SudhanshuAgrawal27/arduino_target_finder_rl/assets/schematic_circuit_diagram.pdf

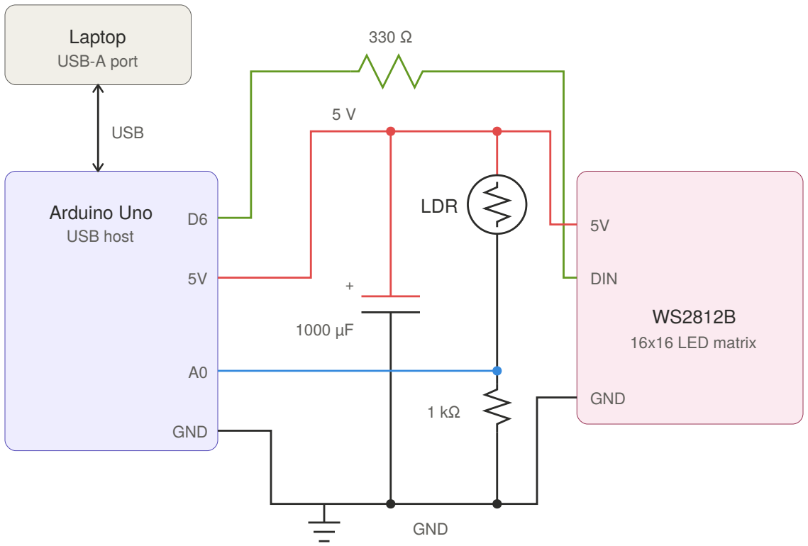
[picture p7: figure]
Laptop USB-A port; Arduino Uno USB host; GND; WS2812B 16x16 LED matrix; DIN; USB; LDR
