SudhanshuAgrawal27/arduino_target_finder_rl/assets/led-grid-picture.png

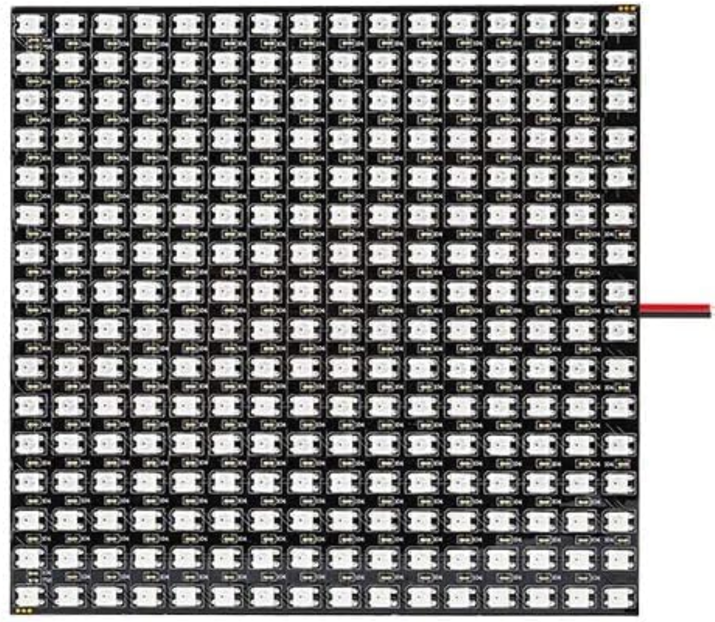
assets/led-grid-picture.png
