SudhanshuAgrawal27/arduino_target_finder_rl/conf/config.yaml

# Fast smoke-test config for train.py. Override any field from the command line,
# e.g.: python3 train.py training.num_epochs=5 ppo.learning_rate=1e-4

defaults:
  - override hydra/job_logging: disabled  # we do our own logging via accelerator.print
  - override hydra/hydra_logging: disabled
  - _self_

hydra:
  run:
    dir: .              # we manage our own run directory (trained_models/<run_name>/)
  output_subdir: null

seeds: [42]  # train one model per seed; override e.g. seeds=[42,43,44]

env:
  grid_size: 16
  subgrid_size: 8
  score_radius: 2
  max_steps: 100
  history_length: 4
  step_penalty: 0.01     # reward cost per step onto an empty (proximity-0) cell
  wall_penalty: 0.05     # reward cost for an illegal move (walking into the subgrid edge, a no-op)
  success_bonus: 1.0     # terminal reward for reaching the target

network:
  hidden_dim: 64
  window_length: 4  # how many of env.history_length's most recent readings the network consumes; must be <= it
  num_layers: 3      # number of hidden Linear+ReLU blocks in the shared trunk

ppo:
  gamma: 0.99          # discount factor
  lam: 0.95            # GAE lambda
  clip_eps: 0.2        # PPO ratio clip range [1-clip_eps, 1+clip_eps]
  value_coef: 0.5      # weight on the value loss term
  entropy_coef: 0.01   # weight on the entropy bonus
  learning_rate: 3.0e-4
  update_epochs: 4     # gradient-update passes over each collected batch
  minibatch_size: 256
  max_grad_norm: 0.5   # global grad-norm clip per update step

training:
  num_epochs: 1              # one epoch = one rollout-collect + PPO-update + checkpoint cycle
  episodes_per_epoch: 1000
  eval_episodes: 20          # eval + baseline + val-loss episodes, run every epoch
  eval_seed: 999              # fixed seed so eval/baseline/val replay the same episodes every epoch

output:
  base_dir: trained_models
  run_name: null       # dir = [timestamp_]<run_name>_seed<seed>; null drops the run_name piece
  timestamp: true      # prepend a timestamp to the dir; set false for deterministic (skippable) names

wandb:
  project: grid-search-rl
  mode: online  # uploads live to your wandb.ai account -- run `wandb login` first
