SudhanshuAgrawal27/arduino_target_finder_rl/trained_models/h64_l3_hist4_ep150_seed43/config.yaml

seeds:
- 43
env:
  grid_size: 16
  subgrid_size: 8
  score_radius: 2
  max_steps: 100
  history_length: 4
  step_penalty: 0.01
  wall_penalty: 0.05
  success_bonus: 1.0
network:
  hidden_dim: 64
  window_length: 4
  num_layers: 3
ppo:
  gamma: 0.99
  lam: 0.95
  clip_eps: 0.2
  value_coef: 0.5
  entropy_coef: 0.01
  learning_rate: 0.0003
  update_epochs: 4
  minibatch_size: 1024
  max_grad_norm: 0.5
training:
  num_epochs: 150
  episodes_per_epoch: 1000
  eval_episodes: 100
  eval_seed: 999
output:
  base_dir: trained_models
  run_name: h64_l3_hist4_ep150
  timestamp: false
wandb:
  project: grid-search-rl
  mode: online
seed_used: 43
