SudhanshuAgrawal27/arduino_target_finder_rl/(commit log)

2026-07-09 initial commit for blind grid search. enabled simple 2 layer model, ppo, simulator, training, fixed eval data
    [config.yaml, config_train.yaml]
2026-07-11 improvements with fixes to eval so that we get avg length on successful samples only. ablations on hidden dim, number of layers, etc.
    [config.yaml]
2026-07-12 enable basic functionality with arduino independently and controlled by python running insid wsl
2026-07-20 implement python based arduino control of led boards with a board control layer, listener layer, python writer layer. simulator is now able to write the current state to a callback function. implemen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
2026-07-20 add ws2812b 16x16 panel driver alongside the max7219 board, with colored row/pixel serial commands and a row-colored 16x16 sweep test
    rename 8x8 sweep test for naming consistency with the new 16x16 one. update arduino README with wiring notes, power/safety caveats, and the full serial protocol table.
2026-07-22 add eval_demo_16-16.py: global-coordinate LED display with a blinking subgrid boundary/target, on the WS2812B panel
    Extends the LED board protocol with length-prefixed multi-point E:/D:
    commands (boundary+target, agent+trail) and a C (clear) command, both
    composited and blinked at ~33Hz by the board's own free-running timer
    independent of serial traffic.
    Fixes two related reliability issues along the way: a heap-exhaustion
    bug in the firmware's line parser (String::substring() per point,
    which could fail deterministically on a long boundary line on the
    Uno's ~2KB SRAM -- replaced with allocation-free char-buffer parsing),
    and the resulting serial corruption race with the autonomous blink
    ti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
    [led_board_client.py, led_board_driver.h, led_serial_listener.ino, max7219_matrix_driver.cpp, power_model.py, ws2812b_matrix_driver.cpp]
2026-07-24 Make the 16x16 agent LED full white, document it, add a 16x16 slide, and integrate LDR sensing
    - Agent LED is now full white (255,255,255) instead of red -- updated
    power_model.py, ws2812b_matrix_driver.cpp, and both READMEs to match
    (including the current-draw note).
    - Added a 16x16 hardware-demo slide to slides.html, mirroring the
    existing 8x8 slide's structure, and re-pointed the "next" notes
    between them.
    - Folded LM358 photoresistor reading into the shared led_serial_listener
    firmware via a new "L" command (independent of ACTIVE_BOARD, since A0
    is unused by both drivers) so the sensor and the LED matrix run from
    one flashed sketch instead of two mutually-exclusive ones. Ad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
2026-07-31 Extract proximity_score() from GridEnvironment._proximity
    Pulls the score-vs-distance formula out into a module-level function so
    other tools (the upcoming LDR calibration/feedback scripts) can import the
    exact trained-policy score levels instead of re-deriving/duplicating them.
    Pure refactor -- GridEnvironment._proximity now just delegates to it.
2026-07-31 Add --calibrate mode to eval_ldr_sweep.py
    Instead of a per-cell heatmap, characterizes LDR delta vs. Manhattan
    distance from the target (one ambient baseline, the window swept 3x,
    pooled per distance bucket) and saves the curve to a JSON file for
    eval_demo_16-16-ldr-feedback.py to turn live readings into the policy's
    trained discrete proximity levels.
    Hardened against two real-hardware failure modes hit while testing against
    the actual board: (1) set_dynamic_layer's reply is now checked -- a
    still-ERR reply after its own internal retries means the LED never
    actually reached the intended cell, so that reading is skipped rather than
    silently trusted; (2) reject_outliers (median-absolute-devia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
2026-07-31 Add real LDR calibration data
    Output of eval_ldr_sweep.py --calibrate against the actual board/sensor:
    a clean, monotonic delta-vs-distance curve (target=(8,8), 3 runs, outlier
    rejection applied) for eval_demo_16-16-ldr-feedback.py to classify live
    readings against.
2026-07-31 Add eval_demo_16-16-ldr-feedback.py: live demo driven by real LDR proximity
    Runs eval_demo_16-16.py's episode loop but swaps the policy's proximity
    observation for a real photoresistor reading instead of the environment's
    geometric distance formula -- game mechanics (movement, reaching the
    target) are untouched, only the "how warm am I" signal changes. Achieved
    by monkeypatching GridEnvironment._proximity at the instance level so
    perform_action's existing flow (and termination) needs no changes.
    Per run: draws the boundary/target with no agent yet, takes a single
    ambient baseline reading for the whole game, then on every step lights the
    agent alone and nearest-neighbor-classifies the result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
2026-07-31 Run the perfect-world simulation first, hide the target during the real LDR run
    Reorders eval_demo_16-16-ldr-feedback.py's two episodes: the noiseless
    "perfect world" simulation now always runs and displays first (target
    visibly lit -- nothing to hide there), followed by the real LDR-driven
    episode, which now deliberately leaves the target unlit for the whole
    episode -- showing it would give away visually what the agent is supposed
    to be sensing for itself via the LDR.
    Target suppression works by sending an out-of-bounds sentinel coordinate
    (NO_TARGET) instead of the real one; ledBoardSetEpisodeLayer's
    inBounds(target) check means the firmware simply never lights it. Since
    the simulation is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
2026-07-31 Make LED board comms more resilient to real-world command failures
    led_board_client.py: raised _MAX_ATTEMPTS from 20 to 30 and replaced the
    fixed 0.05s inter-retry delay with a jittered random.uniform(0.02, 0.08).
    A real eval_ldr_sweep.py --calibrate run showed set_dynamic_layer
    exhausting the old fixed-delay retry budget on ~10% of calls -- far worse
    than independent-coin-flip math would predict, suggesting a fixed delay
    can end up quasi-periodic with the board's own ~30ms blink cycle, so a
    command that loses the race once could keep losing it on every immediate
    retry. Jitter breaks that correlation.
    eval_demo_16-16-ldr-feedback.py: this same failure mode was crashing a
    whole episode partw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
    [led_board_client.py]
2026-07-31 Document the LDR feedback pipeline and known board reliability issue
    README.md: describe eval_ldr_sweep.py --calibrate's noise handling
    (reply-checking, outlier rejection) and eval_demo_16-16-ldr-feedback.py's
    final run order/target-visibility behavior.
    arduino/README.md: note the raised retry budget/jitter in the Reliability
    section, and add a "Known open issue" callout for the real-world ~10%
    per-command failure rate this session's fixes mitigate but haven't fully
    closed -- flagged for whoever picks this up next.
2026-08-04 Preview the target in blue before the real LDR run starts
    Right after the ambient baseline reading (target still hidden for that
    measurement), briefly blink the target blue a few times so a human
    watching the board can see where it is, then let it disappear before
    the LDR-driven episode actually starts. Purely cosmetic -- doesn't
    touch the baseline reading, env._proximity, or the policy.
2026-08-04 Match the real run's step pacing to the perfect-world run's
    ldr_proximity's settle wait (cfg.ldr_linger_seconds) must stay fixed at
    whatever eval_ldr_sweep.py --calibrate used -- the calibration curve is
    only a valid reference for readings that settle the same duration, so
    it can't be slowed down just to make the demo read better. Instead,
    top up the real run's visible per-step pause with however much of
    cfg.step_delay_seconds the settle wait doesn't already cover, so a
    viewer sees the same overall pace in both episodes.
2026-08-04 Add a simulation-only "thinking" overlay for per-action probabilities
    New WS2812B firmware layer (T: command / ledBoardSetThinkingLayer):
    lights up to 4 points -- one per action -- as shades of yellow scaled
    by a 0-255 brightness value, always lit until the next dynamic-layer
    update implicitly clears it. MAX7219 stubs it as unsupported, matching
    the existing episode/dynamic-layer pattern.
    network.py/eval_lib.py expose the full softmax action distribution
    (action_probs), not just the greedy argmax. simulator.run_simulation
    gained an on_think(env, action_probs) hook fired right before each
    mlp_network-engine action.
    eval_demo_16-16-ldr-feedback.py wires on_think=show_thinking into the
    perfec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
2026-08-31 Simplify system diagram to just the host/Arduino connection
2026-08-31 Tighten README language: drop informal phrasing and scope-restating asides, move USB reconnect note to Arduino Setup, swap CLI flashing instructions for the Arduino IDE, blank the Circuit Setup secti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
2026-08-31 Add wiring/USB-passthrough details to Arduino Setup, move docker smoke test there, and add a dedicated Tests section
2026-08-31 Untrack assets/generate_diagrams.py (kept locally, not published) and remove the arduino/ testing and legacy-board sketches plus arduino/README.md, folding its essential setup info into README.md
2026-08-31 Document environment/network defaults in RL Framework, drop the play_manual.py mention
2026-08-31 Widen system diagram arrows, trim redundant qualifiers, mark WS2812B as the default board
    - Widen the gap between host/Arduino boxes in system-diagram.png so the
    serial-direction labels no longer overlap the box edges
    - Drop restated alternatives ("...instead of a computed distance") and fix
    "target LED" -> "target position" (the LDR points at a position, not
    necessarily a lit LED)
    - Note WS2812B as the default board everywhere both boards are introduced
    - Trim conf/eval_demo_config.yaml's stale references to the removed
    eval_demo_8-8.py/eval_demo_16-16.py and its now-dead dry_run field
    - Include a pretrained checkpoint (trained_models/h64_l3_hist4_ep150_seed43/epoch_150,
    hidden_di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
    [config.yaml]
2026-08-31 Restructure problem statement: lead with the abstract 8x8 search, explain the 16x16/subgrid mechanism as a physical LDR-placement constraint, tighten informal phrasing
2026-08-31 Flesh out RL Framework, align default network size with the shipped checkpoint, add placeholders for rig/circuit photos
    - List the per-step reward table explicitly (success bonus, step penalty
    for blank cells, wall penalty for illegal moves) instead of prose only
    - Redraw the network diagram as a vertical, line-by-line flow instead of
    a single horizontal arrow chain
    - Change conf/config.yaml and conf/config_train.yaml defaults to
    hidden_dim=64/num_layers=3, matching the included example checkpoint
    (previously config_train.yaml defaulted to hidden_dim=128/num_layers=2)
    - Remove the V(s_final) bootstrapping aside after the PPO equations
    - Add "coming soon" placeholders for the finished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
2026-09-01 Document power draw in Arduino Setup: why the panel runs off the Arduino's own 5V pin without an external supply
2026-09-02 Auto-detect the Windows username in run_docker.sh, refresh calibration data, add rig photo
    - run_docker.sh/docker_setup.md: auto-detect the Windows username via
    cmd.exe (falling back to $USER) instead of a hardcoded placeholder, so
    the Windows-side SSH key injection actually works for whoever runs it
    - Refresh committed LDR calibration data/plot from a real hardware run
    - Bump the demo config's default seed
    - Add an unreferenced photo of the physical LED panel to assets/ for
    future use (not yet linked from the README)
2026-09-03 Add finished-rig photo and dark-room demo GIF, widen system diagram boxes
    - assets/rig-photo.png: photo of the finished rig replacing the "coming
    soon" placeholder, cropped and resized down to 480px wide (~0.39MB)
    - assets/grid-image.png: resized to match rig-photo.png at 480px wide
    (~0.025MB)
    - assets/board-demo.gif: dark-room demo clip (10s-24s of the source
    video, 2x speed, top 20% cropped, audio stripped, ~300x427 at 10fps,
    ~5.6MB), placed at the end of the problem section
    - assets/system-diagram.py: widen both boxes so the longest line
    ("Serial listener - led_serial_listener.ino") no longer overflows
    past the box edge
    - .gitignore: exclude the raw HEIF/MP4/JPG photo/video so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
2026-09-03 Remove the sim-vs-real benchmark section from the README
    Drop the eval_ldr_benchmark.py step from Evaluation with Arduino, its
    key-files reference, and stray pasted run output that had ended up at
    the end of the file. The script itself is untouched.
2026-09-03 Fix blurry rig/grid images: serve at 2x the CSS display width
    Both were downscaled to exactly their README width="480", which looks
    blurry on any HiDPI/Retina display since the browser has to upscale a
    480px source to fill the actual (higher) device pixel grid. Regenerated
    both at 960px (2x) from their original sources -- the un-cropped
    board_light_image.jpg and the pre-resize grid-image.png recovered from
    git history -- while keeping the README's display width unchanged.
2026-09-03 Update docker_setup.md: document USB/Arduino passthrough, fix stale port claim
    - Remove the claim that ports 6006 (TensorBoard) and 8888 (Jupyter) are
    published -- run_docker.sh doesn't actually expose either
    - Document the Arduino serial device passthrough (--device, wildcard
    --device-cgroup-rules) that run_docker.sh sets up, which wasn't
    mentioned at all
    - Add a "Reconnecting the Arduino" section covering reconnect_usb.sh's
    actual behavior (busid lookup, usbipd attach, device node recreation)
    - Note run_docker.sh's container-name/ssh-port are optional positional
    args with defaults, not hardcoded
2026-09-03 Add circuit diagram to the Circuit Setup section
    Render assets/schematic_circuit_diagram.pdf (the source schematic) to
    assets/circuit-diagram.png at 4x zoom (2040x1410, ~84KB) for a crisp
    README embed, replacing the "coming soon" placeholder. Keep the PDF
    source in the repo too since it's small and is the actual editable
    source, unlike the raw photo/video assets.
